danielkucera/ebus-adapter/README.md

# eBUS to WiFi adapter

This repo conains KiCAD design of eBUS bus powered (without external supply) adapter to WiFi.

## Power consumption:

- 22mA@20V
- 36mA@10V

## Software

It can be used with following firmware: https://github.com/danielkucera/esp8266-arduino-ebus

For control software, ebusd can be used: https://github.com/john30/ebusd/

## Hardware

You can buy finished board in [my Lectronz store](https://www.lectronz.com/stores/danman-eu)

View this project on [CADLAB.io](https://cadlab.io/project/25252).
