danielkucera/ebus-adapter/(threads)

Thread 2 (2020-02-10):

Squeaking DC/DC converter

danielkucera, 2020-02-10:

danielkucera, 2020-02-10:
Waiting for a new one to come

#Aliexpress € 0,68  26%OFF | DC-DC Buck Step-down Power Supply Module 5V-12V 24V to 5V 3.3V 9V 12V Fixed Output High-Current
https://a.aliexpress.com/_TwQF8

Closed 2023-03-21.

Thread 4 (2022-02-24):

User manual and some suggestions for improvement

bogdanm, 2022-02-24:
Hi, I recently bought your adapter from Lectronz, then I realized that I don't actually know what I'm supposed to do with the trimmer. Is there an user manual somewhere?
Staying in the area of general usability, is there a PDF schematic somewhere, or another format that's easy to read? I don't use KiCad and I wouldn't want to install it just to be able to read the schematic.
Thank you.

danielkucera, 2022-02-25:
Hi,
sorry for not providing any details.
Trimmer should be configured to work correctly but if you don't see any data from your bus, you can try adjusting it.

Schematics can be found in releases as described in readme or you can see the project on cadlab.io, see the first line in readme.

Thanks.

bogdanm, 2022-02-25:
Thank you! Also, my bad, I completely missed the cadlab link.

Closed 2022-02-25.

Thread 5 (2022-06-25):

network esp-ebus no longer accessible

Woempia, 2022-06-25:
i no longer see the network with esp-ebus name. Is this no longer accessible once you have been able to connect the adapter to the home wifi network or how can i access it?  i no longer seem to be connected to the home network either

any chance the wifi module is broken?

i initally was able to connect my home assistant to the device (through the ebus add on), but for some reason i can no longer connect

is there a way to reset the device?

Woempia, 2022-06-28:
thank you for helping me (seperate email)

connecting the two PROG pins for over 10 seconds + restart of the device reinstated the signal

Closed 2022-06-28.

Thread 6 (2022-08-11):

Compatible with Vaillant eBus ?

HiQual, 2022-08-11:
Hello.
Before buying your adapter, I just want to check that it is fully compatible with Vaillant eBus ?
Also, is it 2 way - with suitable software can I send instructions to the Vaillant boiler - example, increase flow temperature ?
Many thanks.

danielkucera, 2022-08-13:
Hi, I was using it with vaillant ecotec pro for several years. And yes, you can also send frames with it.

HiQual, 2022-08-13:
Thank you for your answer.  I now want to buy one.  The shop is out of stock at the moment.  Do you have any plans to make the next batch?  If not, do you have any prototype boards you would be willing to sell ?
I will be using your board with an excellent application called MaxAir  (github.com/pihome-shc/PiHomeHVAC) which has just integrated eBus communication so I will be sharing my experiences of your adapter on their discussion groups.

danielkucera, 2022-08-17:
I have just completed 6 boards. They need to be tested and after testing they will go to sale.

HiQual, 2022-08-18:
Thanks for the update.

Closed 2022-08-18.

Thread 7 (2022-09-19):

Adapter draws too much power

m-kloeckner, 2022-09-19:
Thank you for sending the adapter so quickly! I am able to connect to the ebus of my Wolf heating system with ebusd - no issues with that.

However, the adapter seems to draw too much power from my bus. When only connecting the adapter it works fine, but when attaching the adapter and the heating control unit (Wolf BM), both go off. Unfortunately, I need both to be attached.

Is there a way to provide external power to the ESP12F on the adapter?

danielkucera, 2022-09-19:
Hi @m-kloeckner , I am sorry to hear that.

Are you willing to experiment a bit?

Would you mind trying to connect a big capacitor the the ESP power rail? E.g. this one: https://www.conrad.de/de/p/yageo-sy006m4700b5s-1330-elektrolyt-kondensator-radial-bedrahtet-5-mm-4700-f-6-3-v-20-x-h-13-mm-x-30-mm-1-st-442651.html

To the connector between 3V3 and GND (pin2 and 3 or 7):
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

m-kloeckner, 2022-09-20:
I am willing to experiment! However, I currently don't have such a capacitor at hand and would need to order one. (Or find one in old circuits....)

I also found a second eBus interface on the heating unit. I will try this one later today. Maybe it has separate power supply and allows operation of the adapter. I will keep you updated.

m-kloeckner, 2022-09-21:
Short update: It works via the second ebus interface.

danielkucera, 2022-09-21:
Happy to hear that. Thanks for letting me know.

m-kloeckner, 2022-09-21:
Maybe as an information to others: I also considered adjusting the WiFi transmission power by adding a `WiFi.setOutputPower(x)` statement to the code. But I did not try this out.

It seemed that the power consumption was exceeded once the adapter connected to my AP, thus the idea of limiting WiFi power. Maybe that is worth considering.

peterjanto, 2022-11-17:
@m-kloeckner Hi! I have the same problem. In my house is installed CGB-2 and BM-2. Which heating unit you have ? I can't find the second ebus interface.
Thx!

m-kloeckner, 2022-11-18:
@peterjanto I have a CGB-(K)-20 with BM. I found a wiring diagram in the manual (see page 69, Schaltplan) which indicated another eBus interface directly on the control board.

See circle in red:
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

I tried to find a suitable female connector for this interface without success, so I simply soldered two wires to eBus (-) and eBus (+).

However, it turned out that while this works more reliably, it does not fully eliminate the issue. It works for a while but sporadically crashes. Thus, I gave up on the project. In addition to the power issue, the ebusd config for Wolf is quite incomplete and I did not want to investigate much into the readings.

Closed 2022-09-21.

Thread 8 (2022-10-18):

Reverse voltage protection ?

nkrepo, 2022-10-18:
Does the ebus-adapter has reverse voltage protection in case it is connected to ebus with reverse polarity ?

danielkucera, 2022-10-18:
Yes.

nkrepo, 2022-10-18:
Very nice,  I will close the issue, if it is possible add a note in the readme.

Closed 2022-10-18.

Thread 10 (2023-10-19):

Doubt about the circuit

d-solis-tovar, 2023-10-19:
Hi Daniel,

I would like to implement ebus protocol to an existing circuit with esp32 (so I just need the part from UART at ESP32 to EBUS terminal). As I understand from your wiring schematics, I would need to implement just this part of the circuit, right?

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

Thank you in advance!

danielkucera, 2023-10-19:
yes

Closed 2023-10-19.
