danielkucera/ebus-adapter/(commit log)

2017-10-11 first version
    [wiring.kicad_pcb, wiring.sch]
2017-10-17 resize holes for dc/dc
    [wiring.kicad_pcb]
2019-10-27 opamp prototype 1
    [wiring.kicad_pcb, wiring.sch]
2020-04-23 changes towards new regulator
    [wiring.kicad_pcb, wiring.sch]
2020-04-23 separate power supply
    [wiring.sch]
2020-06-15 built-in regulator
    [wiring.kicad_pcb, wiring.sch]
2020-06-15 fix missing trace, v1.1
    [wiring.kicad_pcb, wiring.sch]
2020-06-15 assign values
    [wiring.sch]
2022-11-26 leds, no esp01, bugfixed, old reg
    [wiring.kicad_pcb, wiring.kicad_sch]
2022-11-26 v3.1 preparation
    [wiring.kicad_pcb, wiring.kicad_sch]
2023-08-15 v6.1 kicad 7
    [wiring.kicad_pcb, wiring.kicad_sch]
2023-11-18 change LED footprint to 0603
    [wiring.kicad_pcb, wiring.kicad_sch]
2024-08-06 kicad 8, move led, extend antenna area, 470u cap
    [wiring.kicad_pcb, wiring.kicad_sch]
